Jamal-Ra-Davis/Led-Night-Light/mechanical/charging_base-bottom.stl

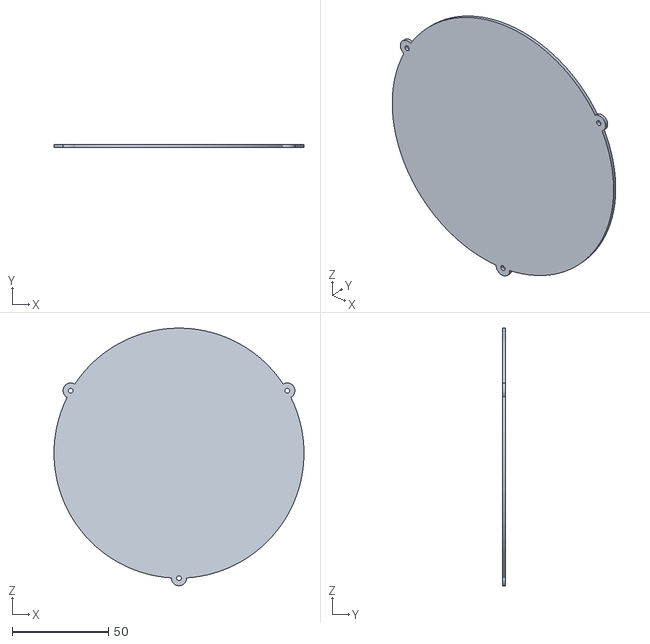
[picture p1: CAD file, 2020-12-05]
mechanical/charging_base-bottom.stl
130.0 x 1.60 x 134.0
