Jamal-Ra-Davis/Led-Night-Light/mechanical/charging_base-top.stl

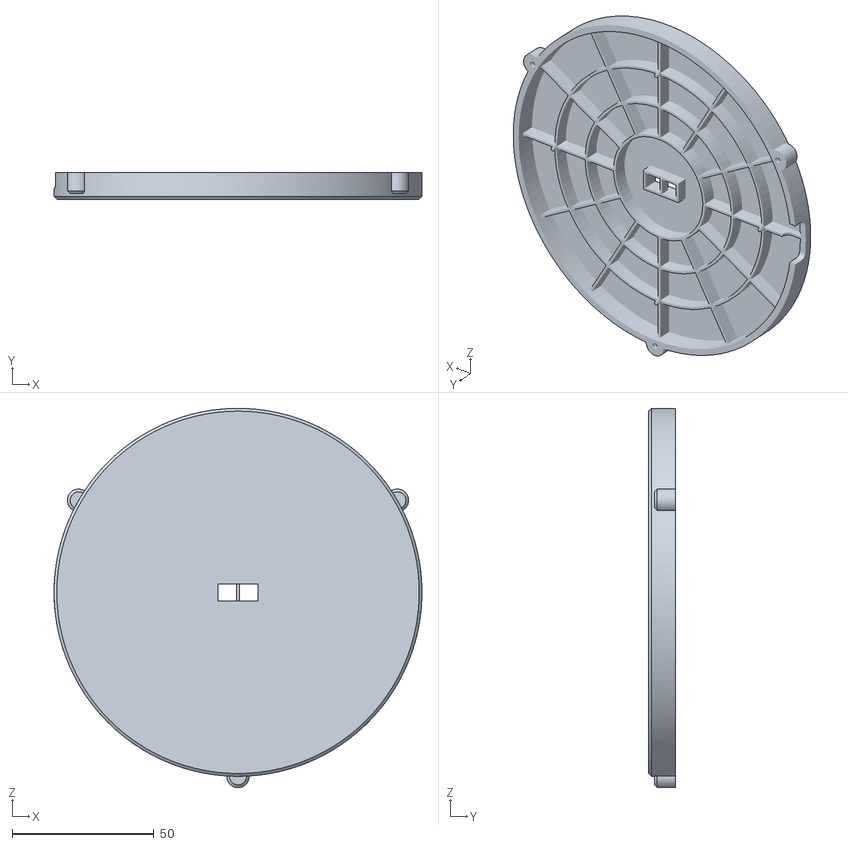
[picture p2: CAD file, 2020-12-05]
mechanical/charging_base-top.stl
130.0 x 9.40 x 134.0
