Jamal-Ra-Davis/Led-Night-Light/(list of files, cad)

Other CAD files:
mechanical/charging_base.f3d
