Jamal-Ra-Davis/Led-Night-Light/Whale_Lamp-jlc-v2.brd

## EAGLE design Whale_Lamp-jlc-v2.brd (2020-11-30)

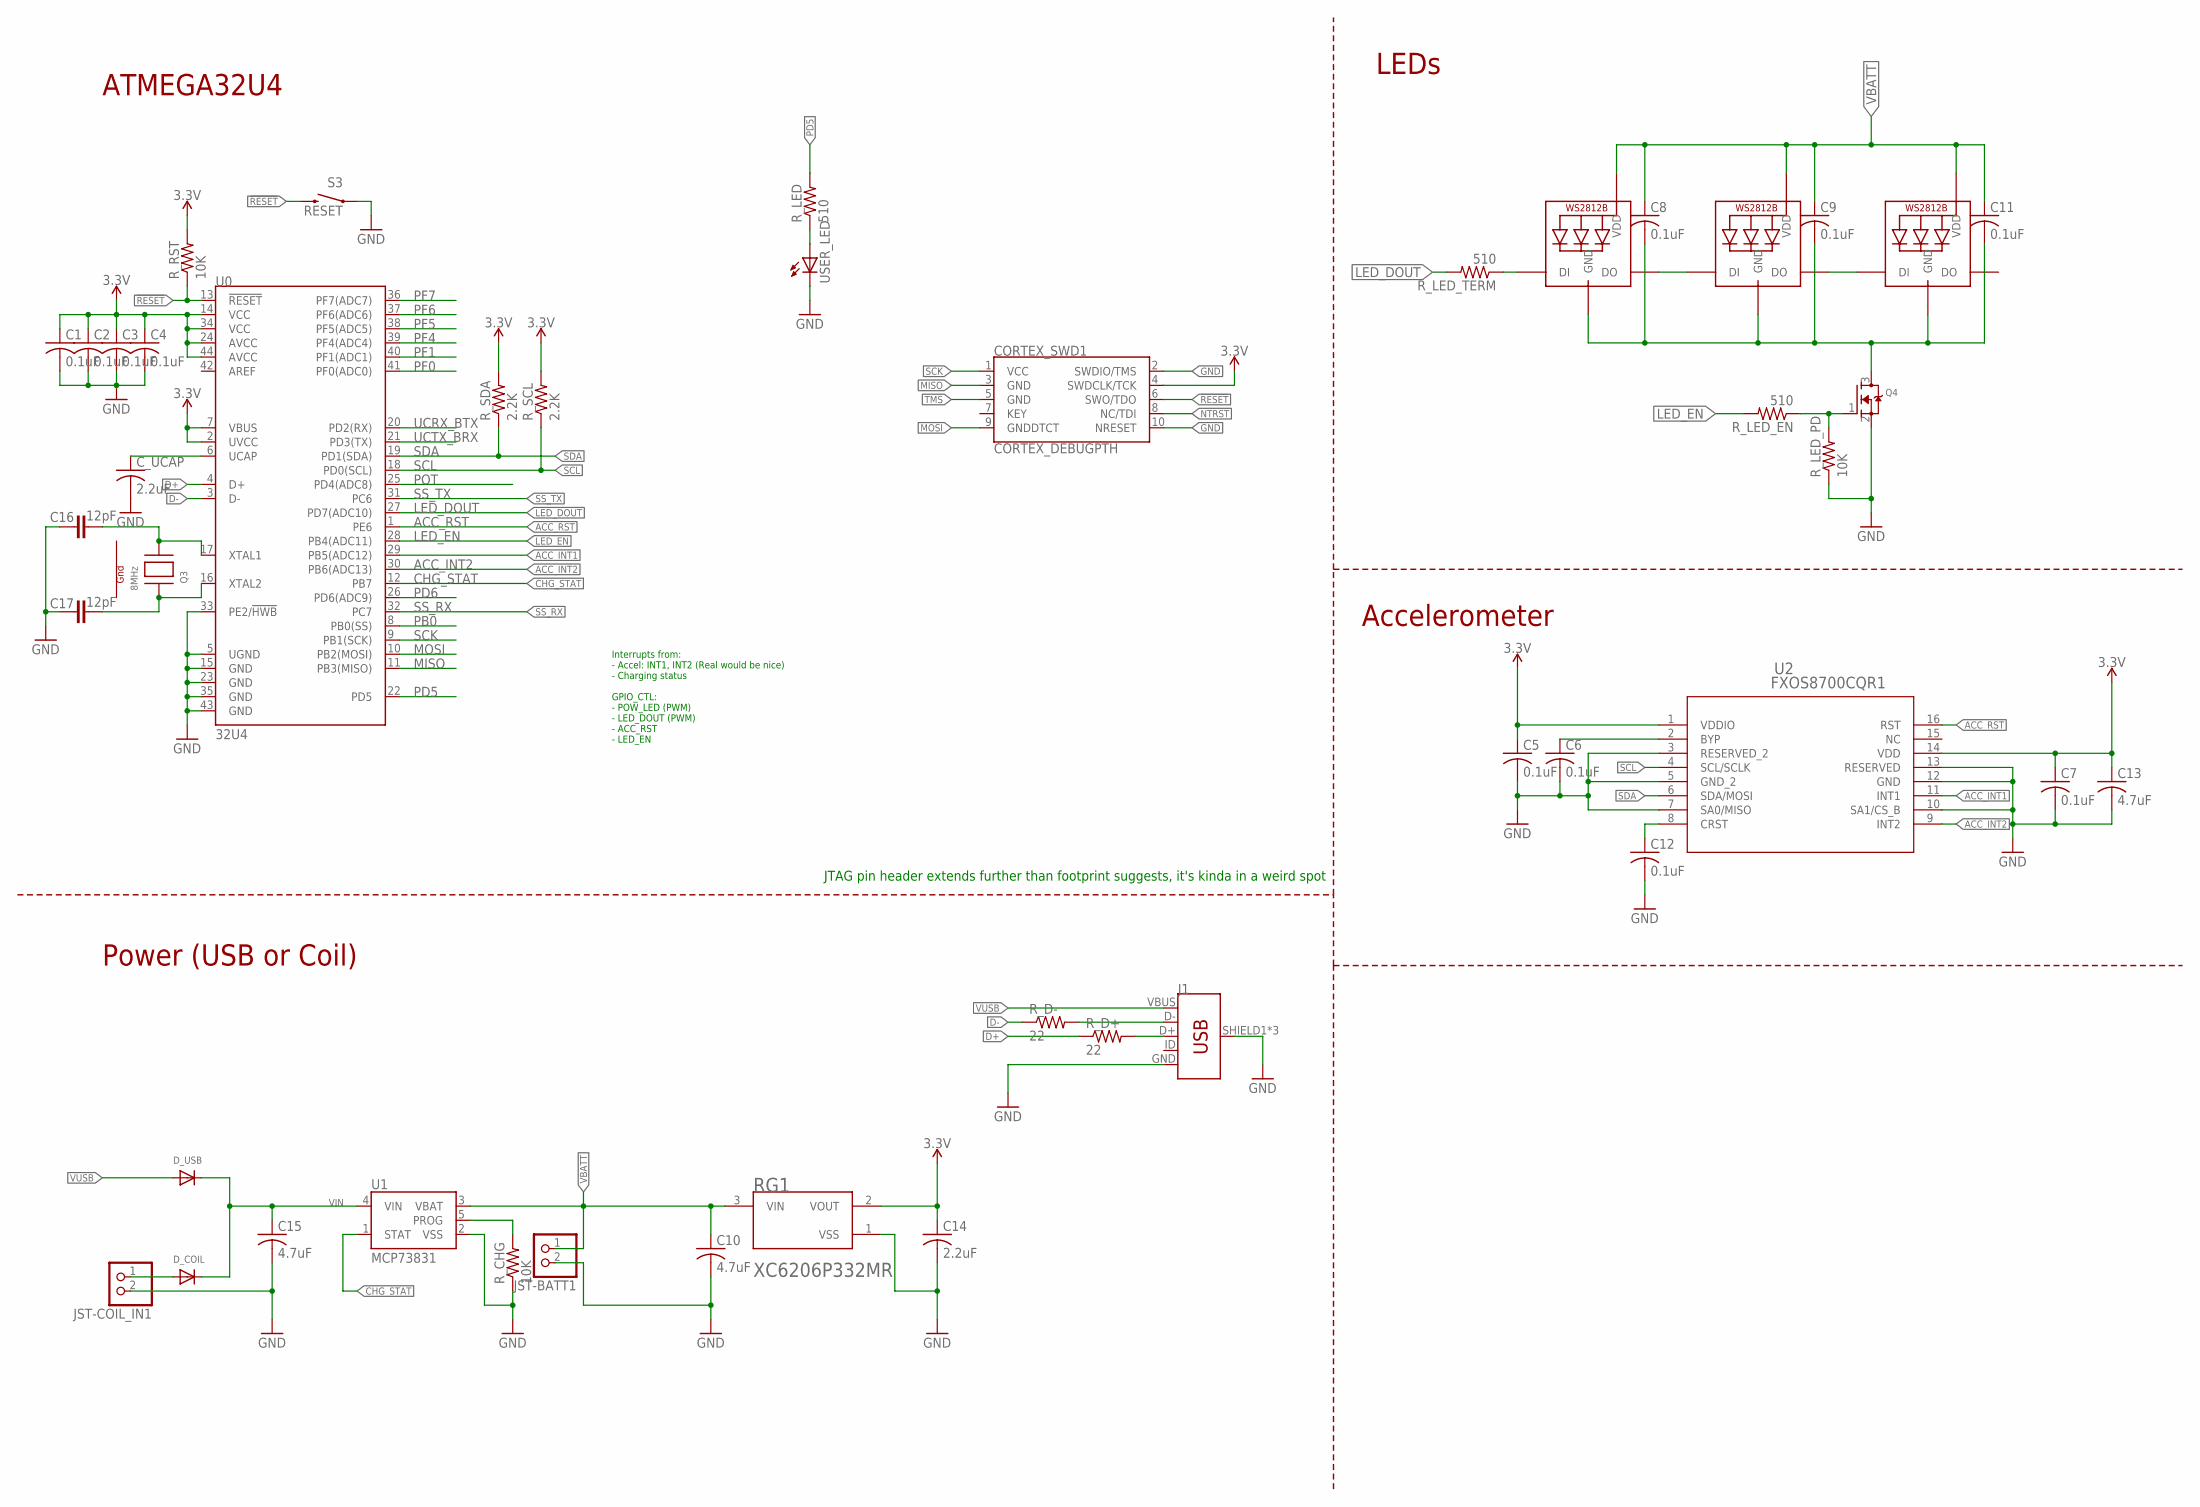
[picture p3: schematic Whale_Lamp-jlc-v2.sch]

Parts:
C1, C2, C3, C4, C5, C6, C7, C8, C9, C11, C12: 0.1uF; C0402
C10, C13, C15: 4.7uF; C0603
C14: 2.2uF; C0603
C16, C17: 12pF; 0402-CAP
CORTEX_SWD1: CORTEX_DEBUGPTH; 2X5-PTH-1.27MM
C_UCAP: 2.2uF; C0603
D_COIL: DIODESOD-123; SOD-123
D_USB: DIODESOD-123; SOD-123
J1: USB_MICRO-B_FEMALE-SMT; USB-B-MICRO-SMD
JST-BATT1: JST_2PIN-THM-RA; JST-PH-2-THM-RA
JST-COIL_IN1: JST_2PIN-THM-RA; JST-PH-2-THM-RA
LED1, LED2, LED3: WS2812B3535; LED3535
Q3: 8MHz; NX3225
Q4: MOSFET-NREFLOW; SOT23
RG1: TOREX_XC6206P332MRTOREX_XC6206P332MR_0_0; TOREX_XC6206P332MR_0
R_CHG: 10K; R0402
R_D+: 22; R0402
R_D-: 22; R0402
R_LED: 510; R0402
R_LED_EN: 510; R0402
R_LED_PD: 10K; R0402
R_LED_TERM: 510; R0402
R_RST: 10K; R0402
R_SCL: 2.2K; R0402
R_SDA: 2.2K; R0402
S3: RESET; TACTILE_SWITCH_SMD_4.6X2.8MM
U0: 32U4; QFN-44
U1: MCP73831; SOT23-5
U2: FXOS8700CQR1; QFN16_3X3_NXP
USER_LED: LEDCHIPLED_0603; CHIPLED_0603

Connections:
3.3V: C1.1, C2.1, C3.1, C4.1, C5.1, C7.1, C13.1, C14.1, CORTEX_SWD1.4 (SWDCLK/TCK), RG1.2 (VOUT), R_RST.2, R_SCL.2, R_SDA.2, U0.2 (UVCC), U0.7 (VBUS), U0.14 (VCC), U0.24 (AVCC), U0.34 (VCC), U0.44 (AVCC), U2.1 (VDDIO), U2.14 (VDD)
!RESET: CORTEX_SWD1.6 (SWO/TDO), R_RST.1, S3.3 (2), S3.4 (2), U0.13 (!RESET)
ACC_INT1: U0.29 (PB5(ADC12)), U2.11 (INT1)
ACC_INT2: U0.30 (PB6(ADC13)), U2.9 (INT2)
ACC_RST: U0.1 (PE6), U2.16 (RST)
CHG_STAT: U0.12 (PB7), U1.1 (STAT)
D+: R_D+.1, U0.4 (D+)
D-: R_D-.1, U0.3 (D-)
G1: Q3.4 (G1)
G2: Q3.2 (G2)
GND: C1.2, C2.2, C3.2, C4.2, C5.2, C6.2, C7.2, C10.2, C12.2, C13.2, C14.2, C15.2, C16.1, C17.1, CORTEX_SWD1.2 (SWDIO/TMS), CORTEX_SWD1.10 (NRESET), C_UCAP.2, J1.GND, J1.SHIELD1 (SHIELD), J1.SHIELD2 (SHIELD), J1.SHIELD3 (SHIELD), JST-BATT1.2 (1), JST-COIL_IN1.2 (1), Q4.2 (S), RG1.1 (VSS), R_CHG.1, R_LED_PD.1, S3.1, S3.2 (1), U0.5 (UGND), U0.15 (GND), U0.23 (GND), U0.33 (PE2/!HWB), U0.35 (GND), U0.43 (GND), U1.2 (VSS), U2.3 (RESERVED_2), U2.5 (GND_2), U2.7 (SA0/MISO), U2.10 (SA1/CS_B), U2.12 (GND), U2.13 (RESERVED), USER_LED.C
LED_DOUT: R_LED_TERM.2, U0.27 (PD7(ADC10))
LED_EN: R_LED_EN.2, U0.28 (PB4(ADC11))
MISO: CORTEX_SWD1.3 (GND), U0.11 (PB3(MISO))
MOSI: CORTEX_SWD1.9 (GNDDTCT), U0.10 (PB2(MOSI))
unnamed: J1.D-, R_D-.2
unnamed: R_CHG.2, U1.5 (PROG)
unnamed: R_LED.1, USER_LED.A
unnamed: C16.2, Q3.3 (X2), U0.17 (XTAL1)
unnamed: C17.2, Q3.1 (X1), U0.16 (XTAL2)
unnamed: LED1.3 (DO), LED2.1 (DI)
unnamed: LED2.3 (DO), LED3.1 (DI)
unnamed: C8.2, C9.2, C11.2, LED1.4 (GND), LED2.4 (GND), LED3.4 (GND), Q4.3 (D)
unnamed: LED1.1 (DI), R_LED_TERM.1
unnamed: Q4.1 (G), R_LED_EN.1, R_LED_PD.2
unnamed: C12.1, U2.8 (CRST)
unnamed: C6.1, U2.2 (BYP)
unnamed: C_UCAP.1, U0.6 (UCAP)
unnamed: J1.D+, R_D+.2
unnamed: D_COIL.A, JST-COIL_IN1.1 (2)
NTRST: CORTEX_SWD1.8 (NC/TDI)
PB0: U0.8 (PB0(SS))
PD5: R_LED.2, U0.22 (PD5)
PD6: U0.26 (PD6(ADC9))
PF0: U0.41 (PF0(ADC0))
PF1: U0.40 (PF1(ADC1))
PF4: U0.39 (PF4(ADC4))
PF5: U0.38 (PF5(ADC5))
PF6: U0.37 (PF6(ADC6))
PF7: U0.36 (PF7(ADC7))
POT: U0.25 (PD4(ADC8))
SCK: CORTEX_SWD1.1 (VCC), U0.9 (PB1(SCK))
SCL: R_SCL.1, U0.18 (PD0(SCL)), U2.4 (SCL/SCLK)
SDA: R_SDA.1, U0.19 (PD1(SDA)), U2.6 (SDA/MOSI)
SS_RX: U0.32 (PC7)
SS_TX: U0.31 (PC6)
TMS: CORTEX_SWD1.5 (GND)
UCRX_BTX: U0.20 (PD2(RX))
UCTX_BRX: U0.21 (PD3(TX))
VBATT: C8.1, C9.1, C10.1, C11.1, JST-BATT1.1 (2), LED1.2 (VDD), LED2.2 (VDD), LED3.2 (VDD), RG1.3 (VIN), U1.3 (VBAT)
VIN: C15.1, D_COIL.C, D_USB.C, U1.4 (VIN)
VUSB: D_USB.A, J1.VBUS

Notes on the sheet:
LEDs
ATMEGA32U4
Power (USB or Coil)
Accelerometer
JTAG pin header extends further than footprint suggests, it's kinda in a weird spot
Interrupts from: - Accel: INT1, INT2 (Real would be nice) - Charging status GPIO_CTL: - POW_LED (PWM) - LED_DOUT (PWM) - ACC_RST - LED_EN

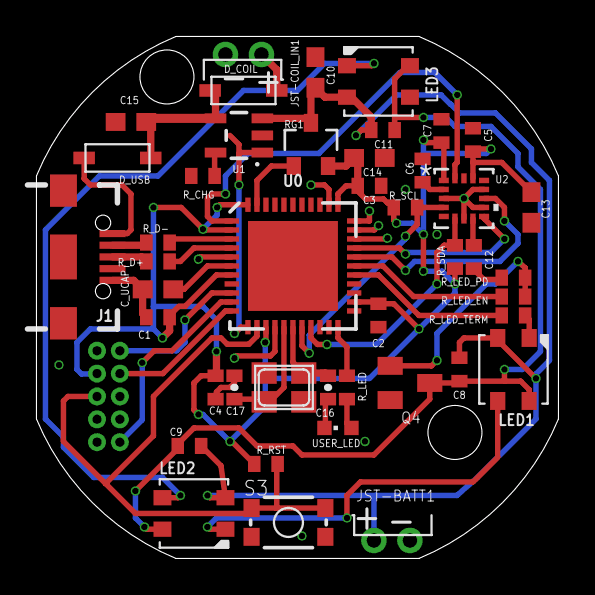
[picture p4: board Whale_Lamp-jlc-v2.brd from above]

Board: 2 copper layers, 29.0 x 29.0 mm, 45 parts (1 on the bottom side), 35 nets.
