Jamal-Ra-Davis/Led-Night-Light/Whale_Lamp-base.brd

## EAGLE design Whale_Lamp-base.brd (2020-11-22)

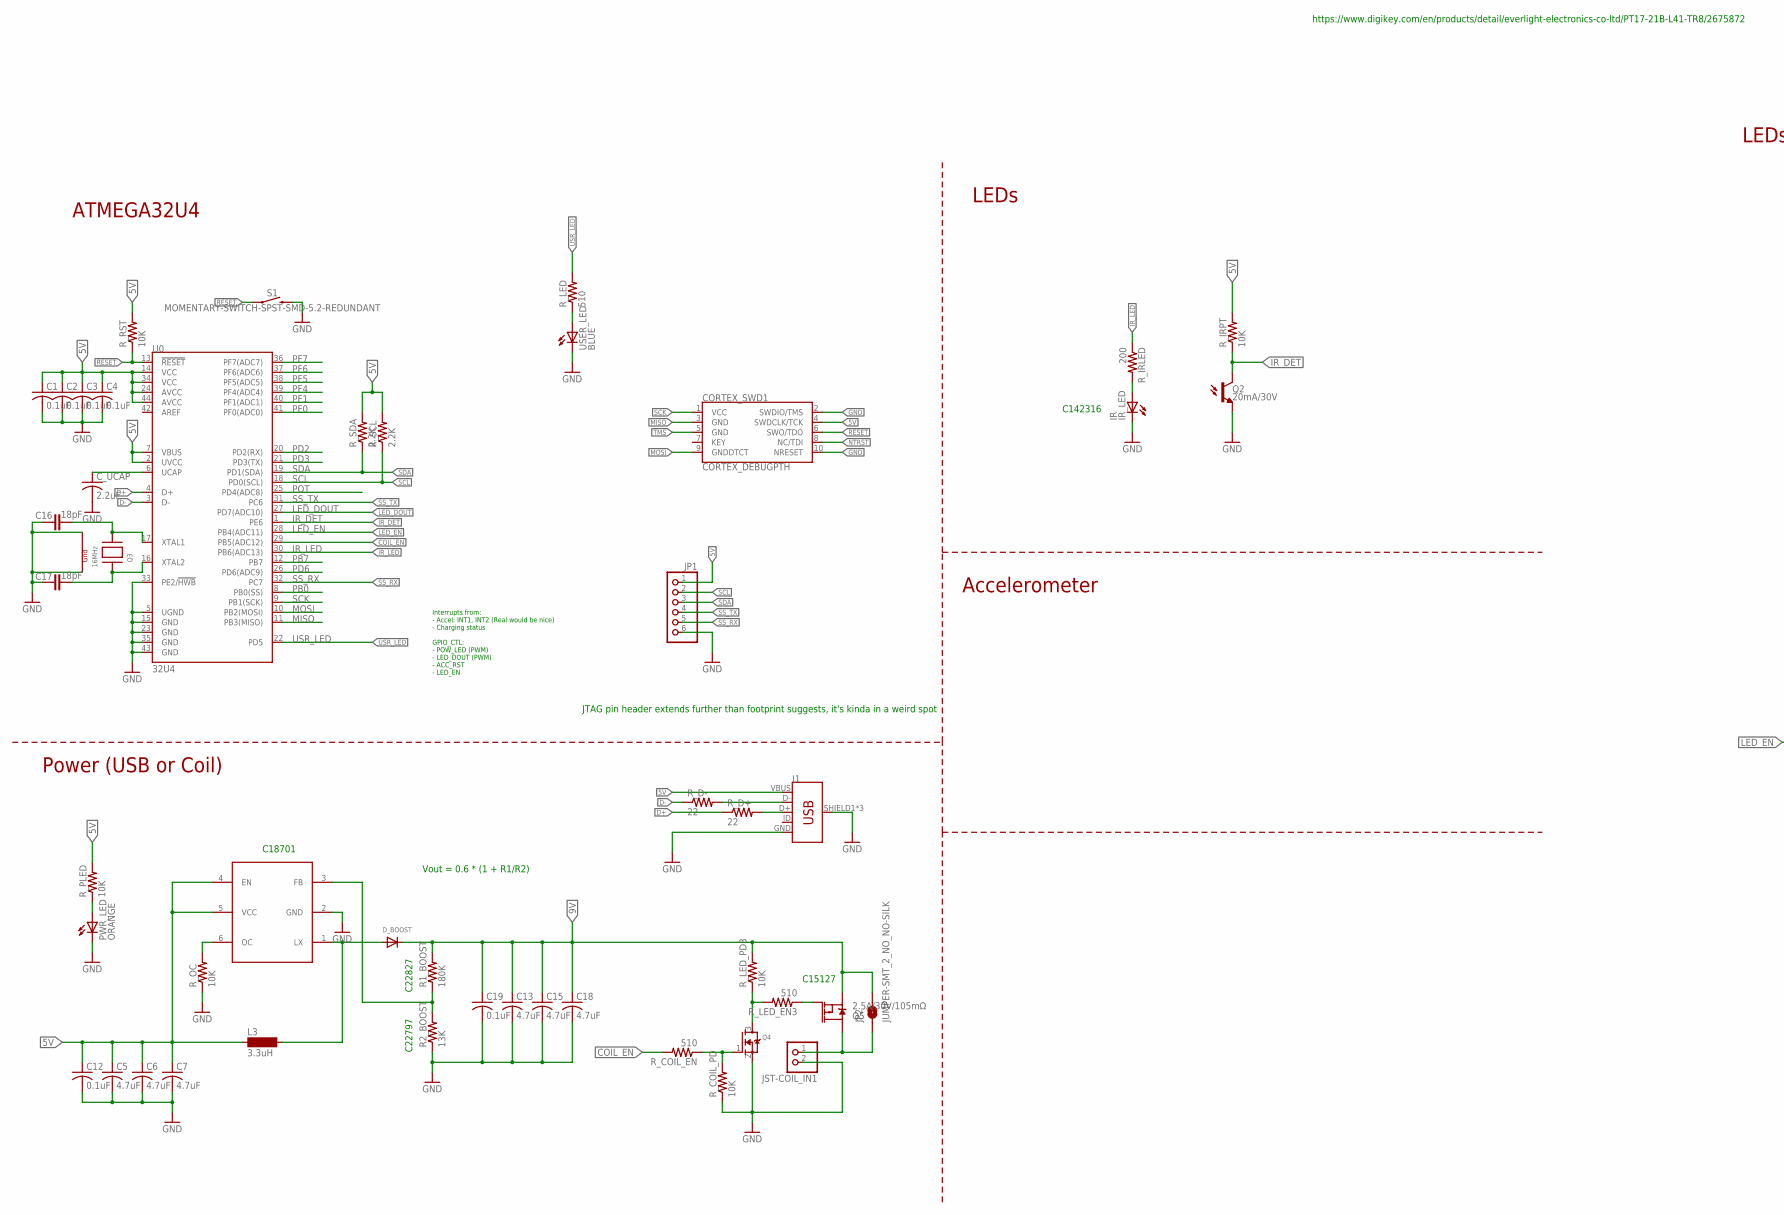
[picture p5: schematic Whale_Lamp-base.sch, part in row 1, column 1]

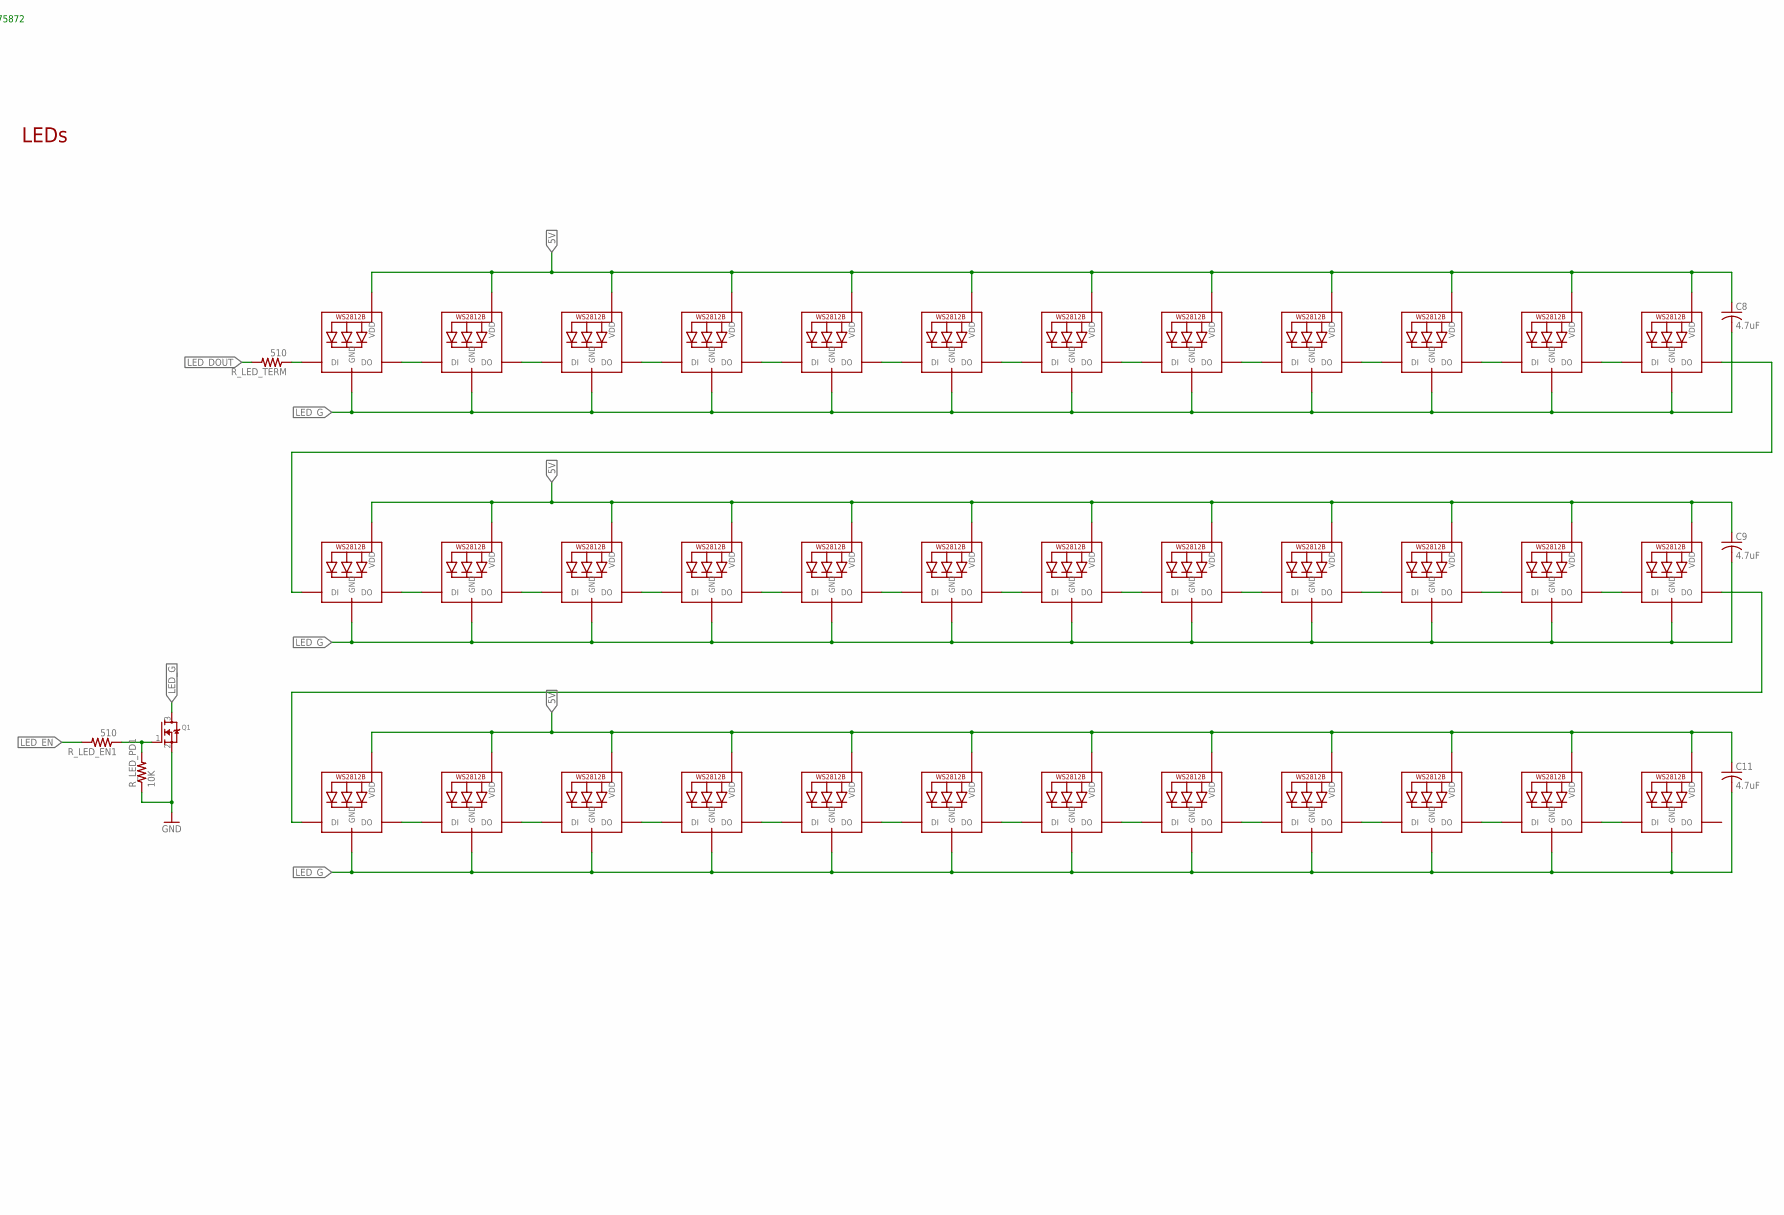
[picture p6: schematic Whale_Lamp-base.sch, part in row 1, column 2]

Parts:
C1, C2, C3, C4, C12, C19: 0.1uF; C0402
C5, C6, C7, C8, C9, C11, C13, C15, C18: 4.7uF; C0603
C16, C17: 18pF; 0402-CAP
CORTEX_SWD1: CORTEX_DEBUGPTH; 2X5-PTH-1.27MM
C_UCAP: 2.2uF; C0603
D_BOOST: DIODESOD-123; SOD-123
FP6291: FP6291; SOT23-6L
IR_LED: IR; CHIPLED_0603
J1: USB_MICRO-B_FEMALE-SMT; USB-B-MICRO-SMD
JP1: PINHD-1X6; 1X06
JP2: JUMPER-SMT_2_NO_NO-SILK; SMT-JUMPER_2_NO_NO-SILK
JST-COIL_IN1: JST_2PIN-THM-RA; JST-PH-2-THM-RA
L3: 3.3uH; MS50
LED1, LED2, LED3, LED4, LED5, LED6, LED7, LED8, LED9, LED10, LED11, LED12, LED13, LED14, LED15, LED16, LED17, LED18, LED19, LED20, LED21, LED22, LED23, LED24, LED25, LED26, LED27, LED28, LED29, LED30, LED31, LED32, LED33, LED34, LED35, LED36: WS2812B_5050N; WS2812B-NARROW
PWR_LED: ORANGE; CHIPLED_0603
Q1, Q4: MOSFET-NREFLOW; SOT23
Q2: 20mA/30V; PT17-21C-L41-TR8
Q3: 16MHz; NX3225
Q5: 2.5A/30V/105mΩ; SOT23-3
R1_BOOST: 180K; R0603
R2_BOOST: 13K; R0603
R_COIL_EN: 510; R0402
R_COIL_PD: 10K; R0402
R_D+: 22; R0402
R_D-: 22; R0402
R_IRLED: 200; R0603
R_IRPT: 10K; R0402
R_LED: 510; R0402
R_LED_EN1, R_LED_EN3: 510; R0402
R_LED_PD1, R_LED_PD3: 10K; R0402
R_LED_TERM: 510; R0402
R_OC: 10K; R0402
R_PLED: 10K; R0402
R_RST: 10K; R0402
R_SCL: 2.2K; R0402
R_SDA: 2.2K; R0402
S1: MOMENTARY-SWITCH-SPST-SMD-5.2-REDUNDANT; TACTILE_SWITCH_SMD_5.2MM
U0: 32U4; QFN-44
USER_LED: BLUE; CHIPLED_0603

Connections:
5V: C1.1, C2.1, C3.1, C4.1, C5.1, C6.1, C7.1, C8.1, C9.1, C11.1, C12.1, CORTEX_SWD1.4 (SWDCLK/TCK), FP6291.4 (EN), FP6291.5 (VCC), J1.VBUS, JP1.1, L3.1, LED1.1-VDD (VDD), LED2.1-VDD (VDD), LED3.1-VDD (VDD), LED4.1-VDD (VDD), LED5.1-VDD (VDD), LED6.1-VDD (VDD), LED7.1-VDD (VDD), LED8.1-VDD (VDD), LED9.1-VDD (VDD), LED10.1-VDD (VDD), LED11.1-VDD (VDD), LED12.1-VDD (VDD), LED13.1-VDD (VDD), LED14.1-VDD (VDD), LED15.1-VDD (VDD), LED16.1-VDD (VDD), LED17.1-VDD (VDD), LED18.1-VDD (VDD), LED19.1-VDD (VDD), LED20.1-VDD (VDD), LED21.1-VDD (VDD), LED22.1-VDD (VDD), LED23.1-VDD (VDD), LED24.1-VDD (VDD), LED25.1-VDD (VDD), LED26.1-VDD (VDD), LED27.1-VDD (VDD), LED28.1-VDD (VDD), LED29.1-VDD (VDD), LED30.1-VDD (VDD), LED31.1-VDD (VDD), LED32.1-VDD (VDD), LED33.1-VDD (VDD), LED34.1-VDD (VDD), LED35.1-VDD (VDD), LED36.1-VDD (VDD), R_IRPT.2, R_PLED.2, R_RST.2, R_SCL.2, R_SDA.2, U0.2 (UVCC), U0.7 (VBUS), U0.14 (VCC), U0.24 (AVCC), U0.34 (VCC), U0.44 (AVCC)
9V: C13.1, C15.1, C18.1, C19.1, D_BOOST.C, JP2.2, Q5.2 (S), R1_BOOST.2, R_LED_PD3.2
!RESET: CORTEX_SWD1.6 (SWO/TDO), R_RST.1, S1.1, S1.2 (1), U0.13 (!RESET)
COIL_EN: R_COIL_EN.2, U0.29 (PB5(ADC12))
D+: R_D+.1, U0.4 (D+)
D-: R_D-.1, U0.3 (D-)
GND: C1.2, C2.2, C3.2, C4.2, C5.2, C6.2, C7.2, C12.2, C13.2, C15.2, C16.1, C17.1, C18.2, C19.2, CORTEX_SWD1.2 (SWDIO/TMS), CORTEX_SWD1.10 (NRESET), C_UCAP.2, FP6291.2 (GND), IR_LED.C, J1.GND, J1.SHIELD1 (SHIELD), J1.SHIELD2 (SHIELD), J1.SHIELD3 (SHIELD), JP1.6, JST-COIL_IN1.2 (1), PWR_LED.C, Q1.2 (S), Q2.E, Q3.2 (G2), Q3.4 (G1), Q4.2 (S), R2_BOOST.1, R_COIL_PD.1, R_LED_PD1.1, R_OC.1, S1.3 (2), S1.4 (2), U0.5 (UGND), U0.15 (GND), U0.23 (GND), U0.33 (PE2/!HWB), U0.35 (GND), U0.43 (GND), USER_LED.C
IR_DET: Q2.C, R_IRPT.1, U0.1 (PE6)
IR_LED: R_IRLED.1, U0.30 (PB6(ADC13))
LED_DOUT: R_LED_TERM.2, U0.27 (PD7(ADC10))
LED_EN: R_LED_EN1.2, U0.28 (PB4(ADC11))
LED_G: C8.2, C9.2, C11.2, LED1.3-GND (GND), LED2.3-GND (GND), LED3.3-GND (GND), LED4.3-GND (GND), LED5.3-GND (GND), LED6.3-GND (GND), LED7.3-GND (GND), LED8.3-GND (GND), LED9.3-GND (GND), LED10.3-GND (GND), LED11.3-GND (GND), LED12.3-GND (GND), LED13.3-GND (GND), LED14.3-GND (GND), LED15.3-GND (GND), LED16.3-GND (GND), LED17.3-GND (GND), LED18.3-GND (GND), LED19.3-GND (GND), LED20.3-GND (GND), LED21.3-GND (GND), LED22.3-GND (GND), LED23.3-GND (GND), LED24.3-GND (GND), LED25.3-GND (GND), LED26.3-GND (GND), LED27.3-GND (GND), LED28.3-GND (GND), LED29.3-GND (GND), LED30.3-GND (GND), LED31.3-GND (GND), LED32.3-GND (GND), LED33.3-GND (GND), LED34.3-GND (GND), LED35.3-GND (GND), LED36.3-GND (GND), Q1.3 (D)
MISO: CORTEX_SWD1.3 (GND), U0.11 (PB3(MISO))
MOSI: CORTEX_SWD1.9 (GNDDTCT), U0.10 (PB2(MOSI))
unnamed: LED1.2-DOUT (DO), LED2.4-DIN (DI)
unnamed: LED4.2-DOUT (DO), LED5.4-DIN (DI)
unnamed: LED5.2-DOUT (DO), LED6.4-DIN (DI)
unnamed: LED7.2-DOUT (DO), LED8.4-DIN (DI)
unnamed: LED8.2-DOUT (DO), LED9.4-DIN (DI)
unnamed: Q4.1 (G), R_COIL_EN.1, R_COIL_PD.2
unnamed: R_LED.1, USER_LED.A
unnamed: LED13.2-DOUT (DO), LED14.4-DIN (DI)
unnamed: C16.2, Q3.3 (X2), U0.17 (XTAL1)
unnamed: C17.2, Q3.1 (X1), U0.16 (XTAL2)
unnamed: LED14.2-DOUT (DO), LED15.4-DIN (DI)
unnamed: LED12.2-DOUT (DO), LED13.4-DIN (DI)
unnamed: LED16.2-DOUT (DO), LED17.4-DIN (DI)
unnamed: LED17.2-DOUT (DO), LED18.4-DIN (DI)
unnamed: LED19.2-DOUT (DO), LED20.4-DIN (DI)
unnamed: LED20.2-DOUT (DO), LED21.4-DIN (DI)
unnamed: LED21.2-DOUT (DO), LED22.4-DIN (DI)
unnamed: Q5.1 (G), R_LED_EN3.1
unnamed: LED22.2-DOUT (DO), LED23.4-DIN (DI)
unnamed: C_UCAP.1, U0.6 (UCAP)
unnamed: LED23.2-DOUT (DO), LED24.4-DIN (DI)
unnamed: LED15.2-DOUT (DO), LED16.4-DIN (DI)
unnamed: PWR_LED.A, R_PLED.1
unnamed: LED18.2-DOUT (DO), LED19.4-DIN (DI)
unnamed: LED25.2-DOUT (DO), LED26.4-DIN (DI)
unnamed: LED26.2-DOUT (DO), LED27.4-DIN (DI)
unnamed: LED24.2-DOUT (DO), LED25.4-DIN (DI)
unnamed: LED28.2-DOUT (DO), LED29.4-DIN (DI)
unnamed: LED29.2-DOUT (DO), LED30.4-DIN (DI)
unnamed: LED31.2-DOUT (DO), LED32.4-DIN (DI)
unnamed: LED32.2-DOUT (DO), LED33.4-DIN (DI)
unnamed: LED34.2-DOUT (DO), LED35.4-DIN (DI)
unnamed: LED2.2-DOUT (DO), LED3.4-DIN (DI)
unnamed: LED35.2-DOUT (DO), LED36.4-DIN (DI)
unnamed: LED27.2-DOUT (DO), LED28.4-DIN (DI)
unnamed: LED30.2-DOUT (DO), LED31.4-DIN (DI)
unnamed: Q1.1 (G), R_LED_EN1.1, R_LED_PD1.2
unnamed: LED1.4-DIN (DI), R_LED_TERM.1
unnamed: LED10.2-DOUT (DO), LED11.4-DIN (DI)
unnamed: LED11.2-DOUT (DO), LED12.4-DIN (DI)
unnamed: JP2.1, JST-COIL_IN1.1 (2), Q5.3 (D)
unnamed: LED3.2-DOUT (DO), LED4.4-DIN (DI)
unnamed: LED6.2-DOUT (DO), LED7.4-DIN (DI)
unnamed: IR_LED.A, R_IRLED.2
unnamed: LED33.2-DOUT (DO), LED34.4-DIN (DI)
unnamed: FP6291.6 (OC), R_OC.2
unnamed: J1.D-, R_D-.2
unnamed: D_BOOST.A, FP6291.1 (LX), L3.2
unnamed: J1.D+, R_D+.2
unnamed: FP6291.3 (FB), R1_BOOST.1, R2_BOOST.2
unnamed: LED9.2-DOUT (DO), LED10.4-DIN (DI)
NTRST: CORTEX_SWD1.8 (NC/TDI)
PB0: U0.8 (PB0(SS))
PB7: U0.12 (PB7)
PCH_GATE: Q4.3 (D), R_LED_EN3.2, R_LED_PD3.1
PD2: U0.20 (PD2(RX))
PD3: U0.21 (PD3(TX))
PD6: U0.26 (PD6(ADC9))
PF0: U0.41 (PF0(ADC0))
PF1: U0.40 (PF1(ADC1))
PF4: U0.39 (PF4(ADC4))
PF5: U0.38 (PF5(ADC5))
PF6: U0.37 (PF6(ADC6))
PF7: U0.36 (PF7(ADC7))
POT: U0.25 (PD4(ADC8))
SCK: CORTEX_SWD1.1 (VCC), U0.9 (PB1(SCK))
SCL: JP1.2, R_SCL.1, U0.18 (PD0(SCL))
SDA: JP1.3, R_SDA.1, U0.19 (PD1(SDA))
SS_RX: JP1.5, U0.32 (PC7)
SS_TX: JP1.4, U0.31 (PC6)
TMS: CORTEX_SWD1.5 (GND)
USR_LED: R_LED.2, U0.22 (PD5)

Notes on the sheet:
LEDs
ATMEGA32U4
Power (USB or Coil)
Accelerometer
JTAG pin header extends further than footprint suggests, it's kinda in a weird spot
Interrupts from: - Accel: INT1, INT2 (Real would be nice) - Charging status GPIO_CTL: - POW_LED (PWM) - LED_DOUT (PWM) - ACC_RST - LED_EN
C15127
https://www.digikey.com/en/products/detail/everlight-electronics-co-ltd/PT17-21B-L41-TR8/2675872
C142316
C18701
Vout = 0.6 * (1 + R1/R2)
C22797
C22827

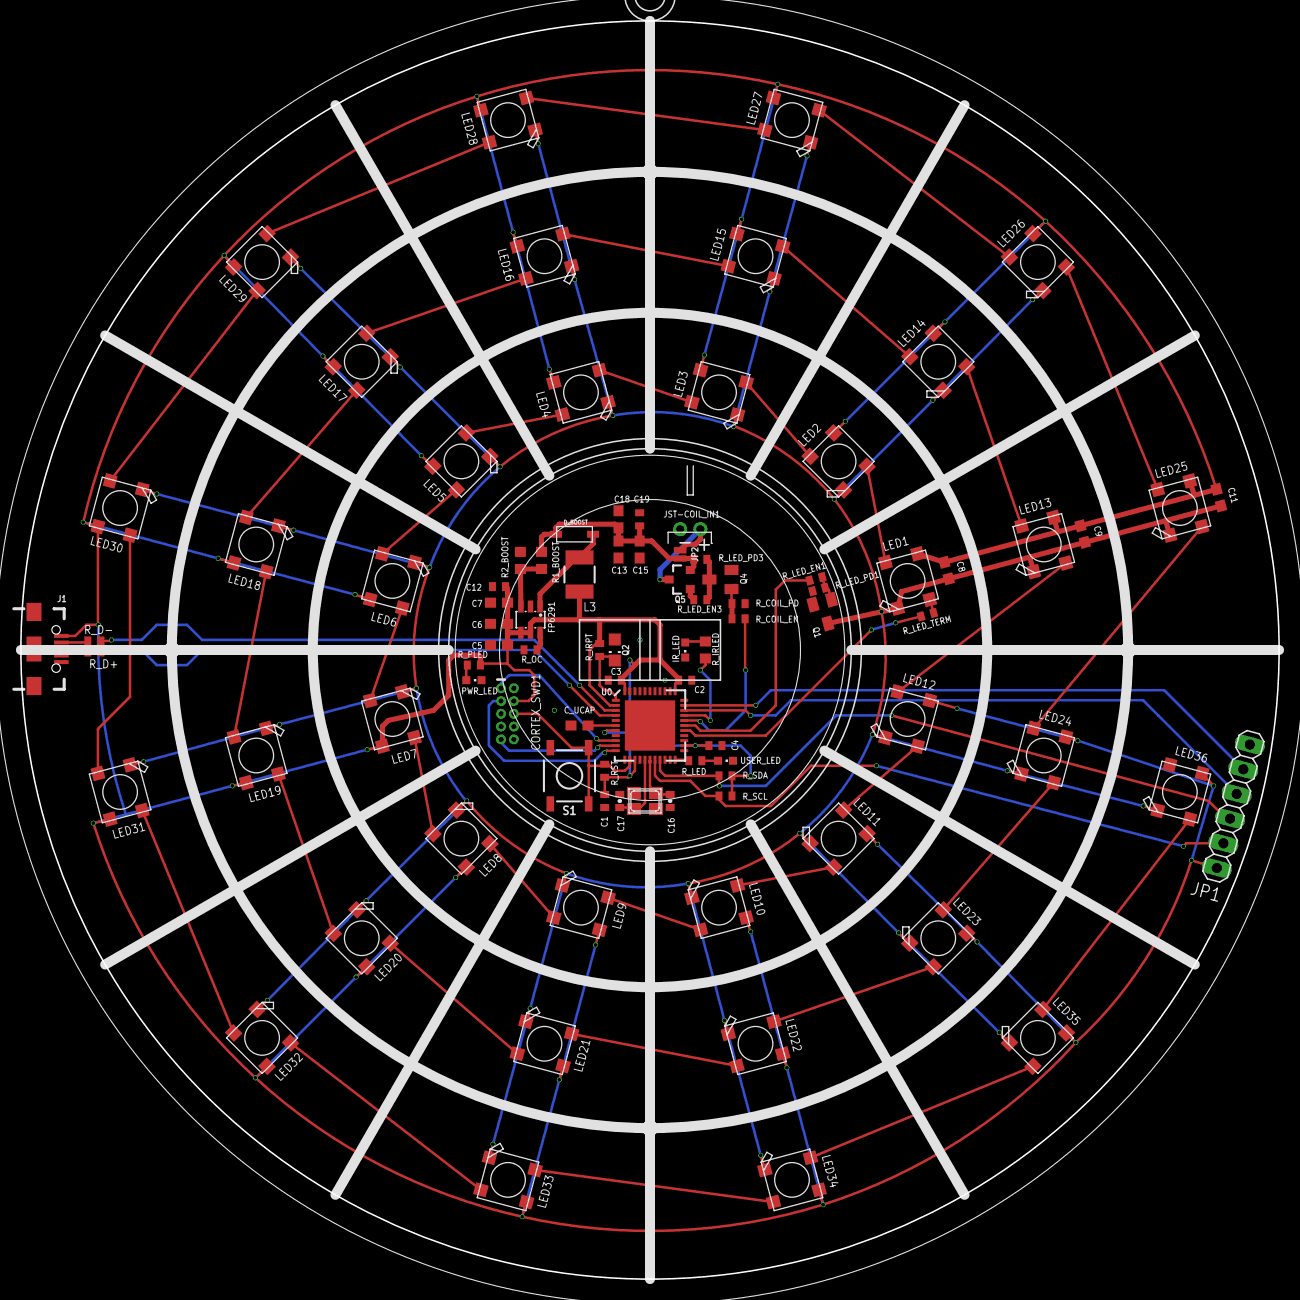
[picture p7: board Whale_Lamp-base.brd from above]

Board: 2 copper layers, 125.0 x 125.0 mm, 91 parts (0 on the bottom side), 72 nets.
