Jamal-Ra-Davis/Led-Night-Light/(commit log)

2020-11-21 finished board layout
    [Whale_Lamp-base.brd, Whale_Lamp-base.sch]
2020-11-22 Silkscreen cleanup and added additional info into schematic
    [Whale_Lamp-base.brd, Whale_Lamp-base.sch]
2020-11-22 Added labels to ext header
    [Whale_Lamp-base.brd]
2020-11-23 added assembly files
    [Whale_Lamp-base.csv, Whale_Lamp-base_centroid.csv]
2020-11-23 Added gerber zip file
2020-12-02 added start of firmware for charging base
2020-12-05 Added mechanical directory to store stls for charging base
    [charging_base-bottom.stl, charging_base-top.stl, charging_base.f3d]
